zwilcox/RetroActiveDesign/Assembler/Error Message.jpg

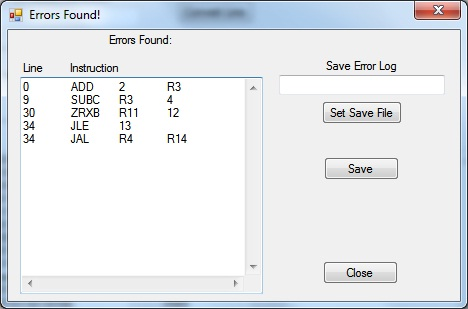
Assembler/Error Message.jpg
