zwilcox/RetroActiveDesign/Assembler/Assembler.jpg

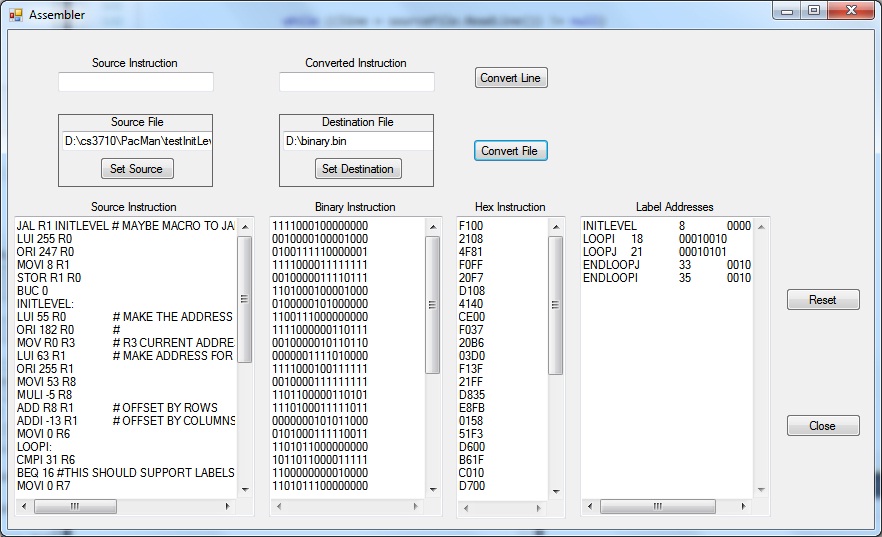
Assembler/Assembler.jpg
