zwilcox/RetroActiveDesign/Application/ImageToGlyph/README.txt

The glyph jpegs are available at the following URL:

http://eng.utah.edu/~ferro/JPEG2.zip
