zwilcox/RetroActiveDesign/System Schematic.bmp

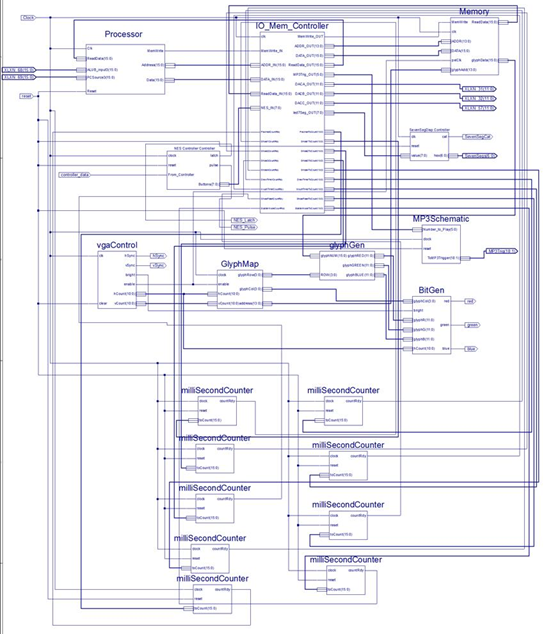
System Schematic.bmp
