zwilcox/RetroActiveDesign/Specification/Schematic User Guide.pdf

# Top Level Schematic:

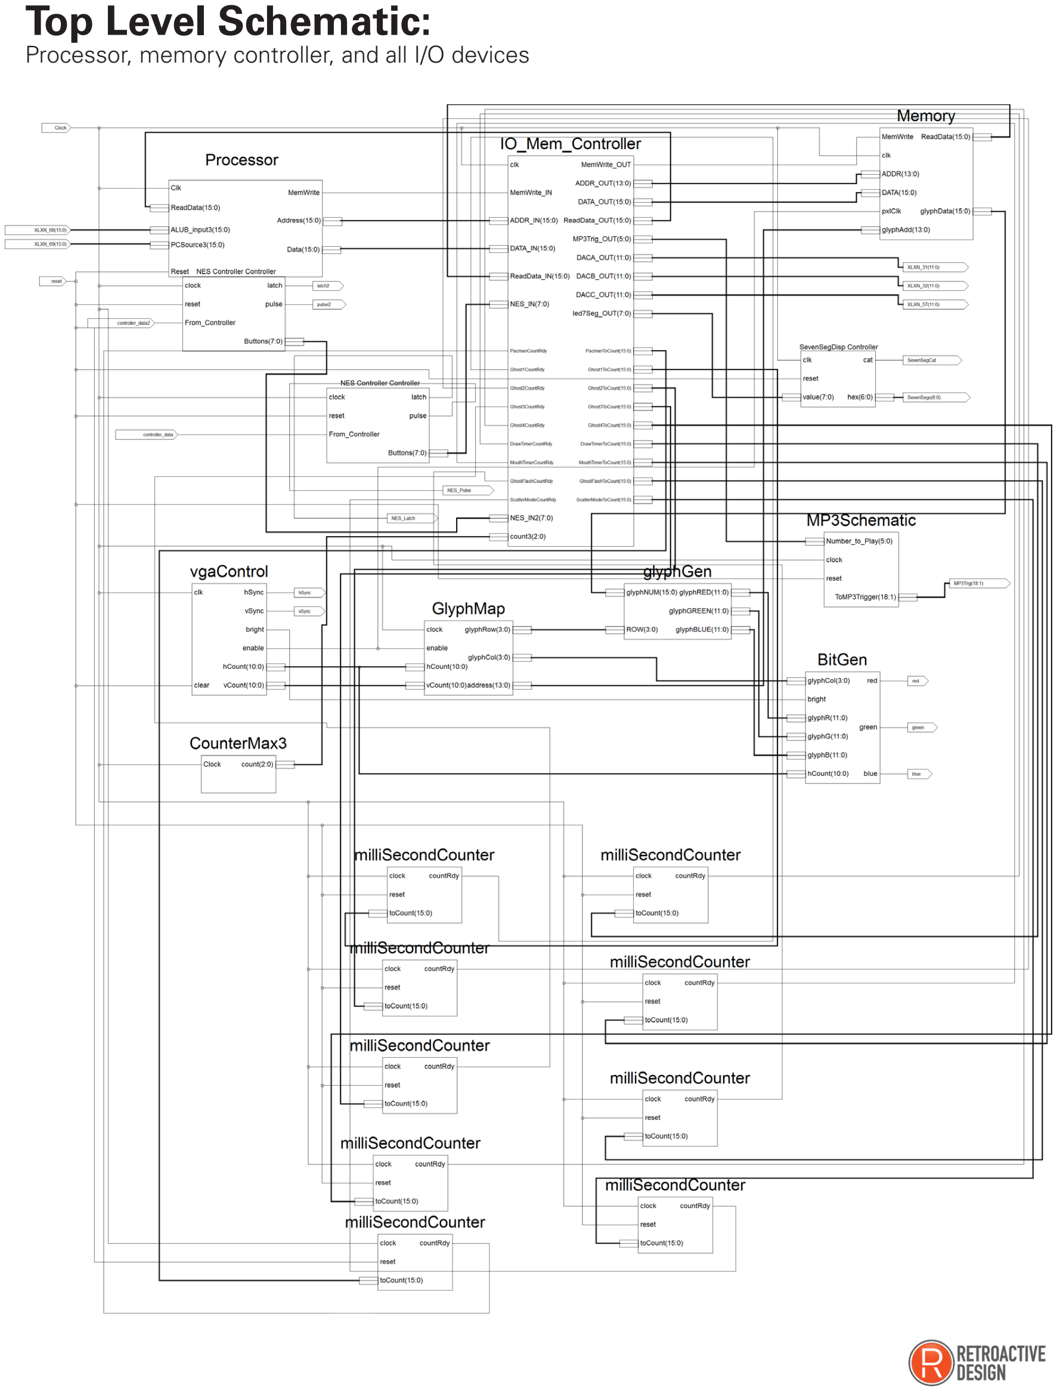
[picture p14: page 1]

Processor, memory controller, and all I/O devices

# Processor Schematic:

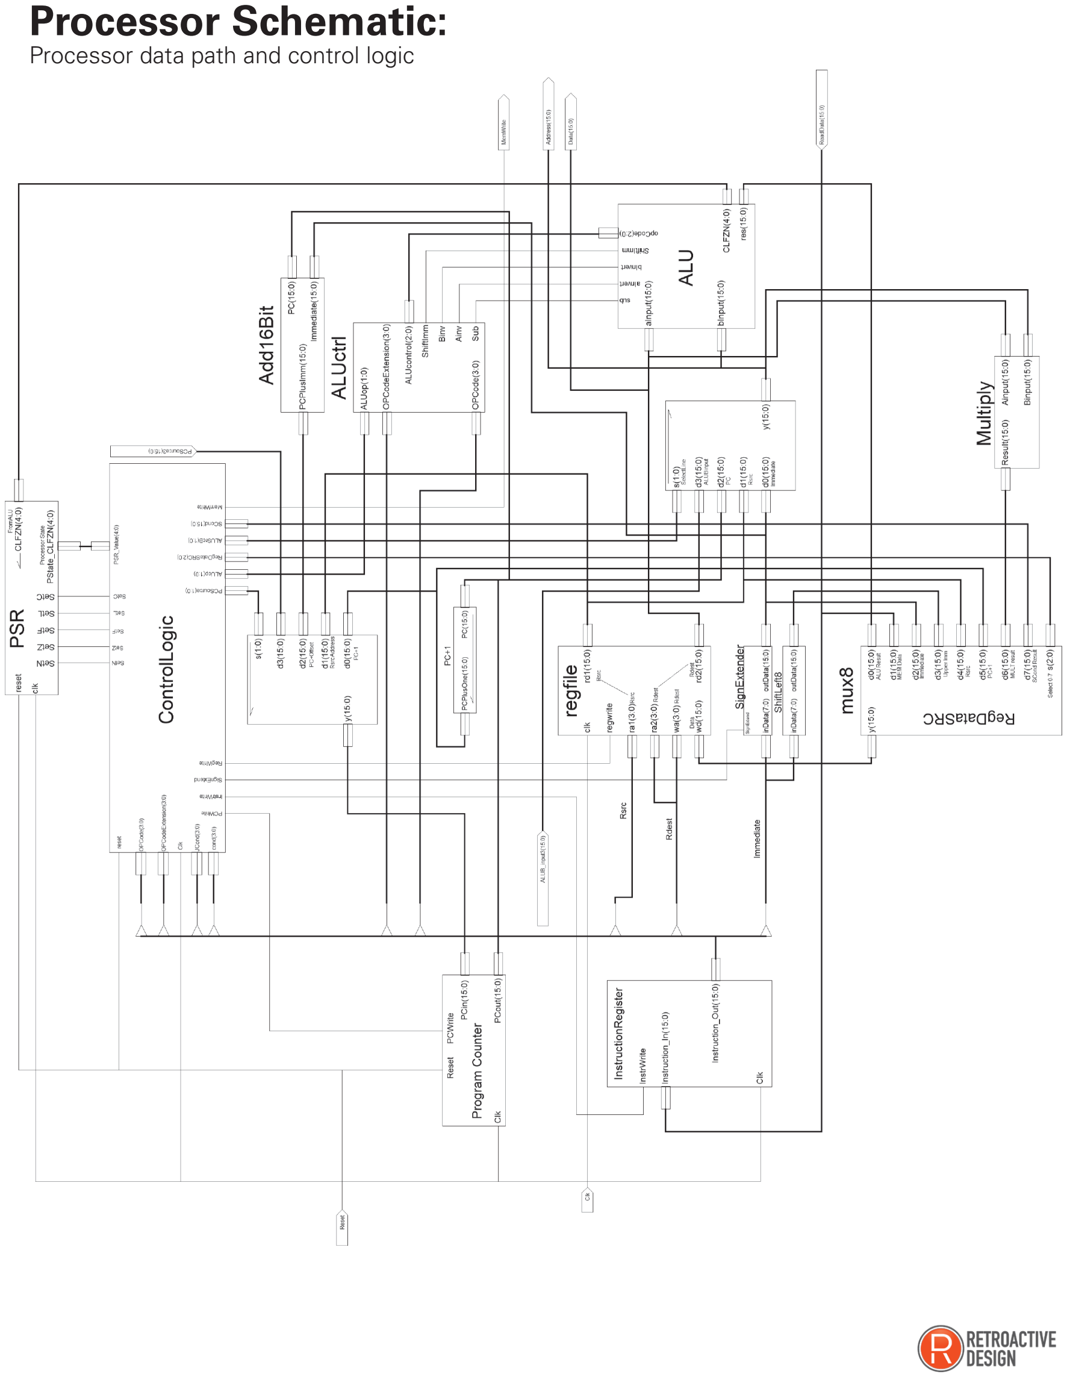
[picture p15: page 2]

Processor data path and control logic

# MP3 Controller Schematic:

MP3 Controller with clock divider.

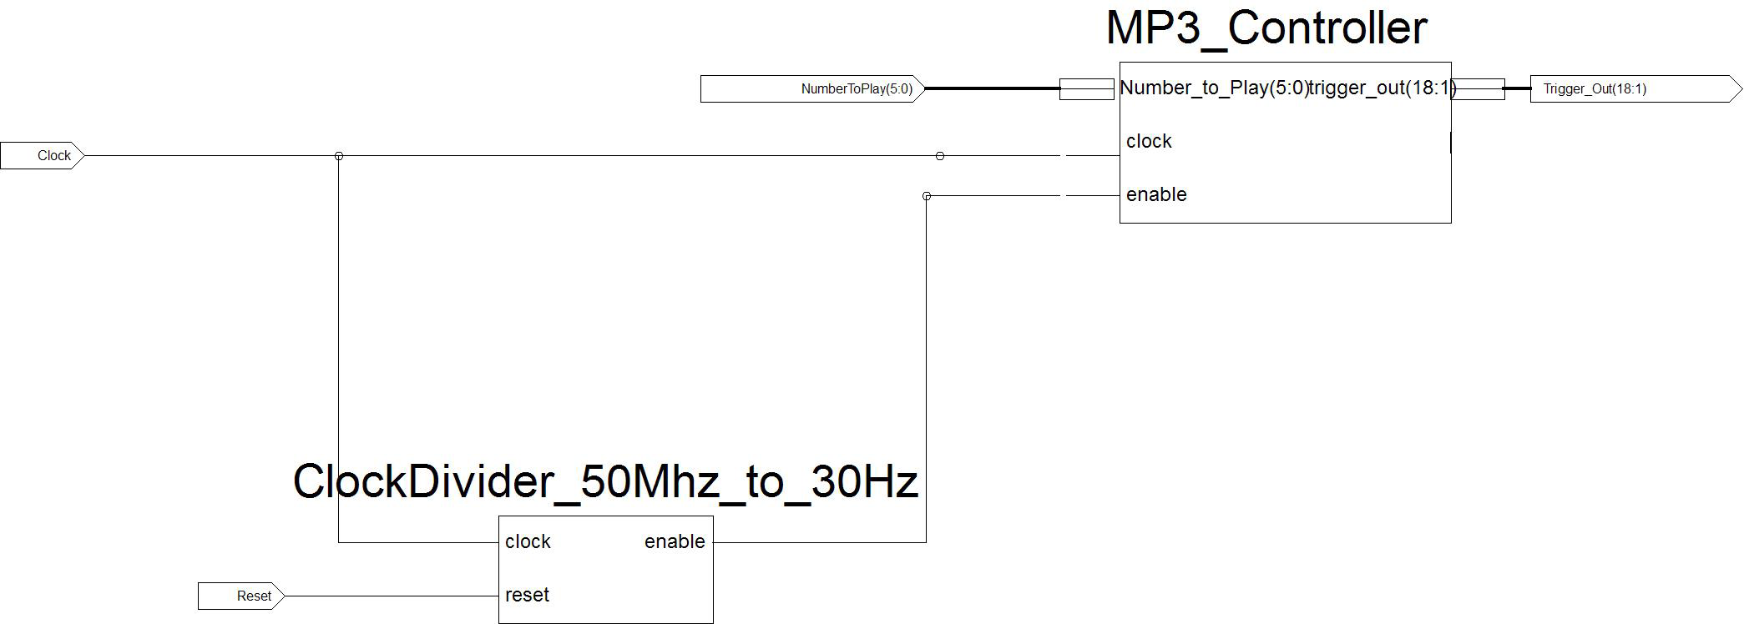
[picture p16: figure]

# NES Controller Schematic:

Clock divider and NESController state machine.

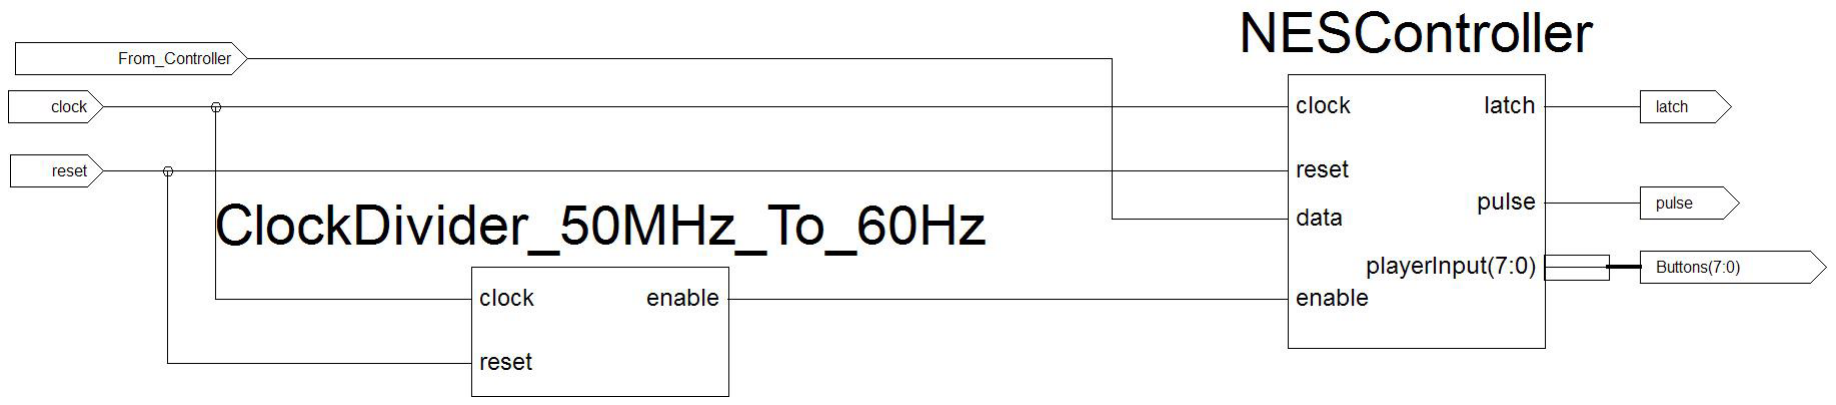
[picture p17: figure]
