zwilcox/RetroActiveDesign/Application/AssemblyCode/working_and_tmp_asm_files/testAssembly.txt

LUI 255 r1
MOVI 255 r6
OR r1 r6
MOVI 254 r7
OR r1 r7
MOVI 253 r8
OR r1 r8
MOVI 252 r9
OR r1 r9
MOVI 251 r10
OR r1 r10
MOVI 250 r11
OR r1 r11
MOVI 250 r12
OR r1 r12
MOVI 1 r5
LOAD r2 r6
CMPI 1 r2
BNE 3
STOR r5 r11
BUC -4
LOAD r2 r7
CMPI 1 r2
BNE 3
MOVI 18 r2
STOR r2 r11
LOAD r2 r8
CMPI 1 r2
BNE 3
MOVI 17 r2
STOR r2 r11
LOAD r2 r9
CMPI 1 r2
BNE 2
ADDI 1 r5
LOAD r2 r10
CMPI 1 r2
BNE 2
ADDI -1 r5
CMPI 13 r5
BGE 2
MOVI 1 r5
CMPI 0 r5
BLE 2
MOVI 12 r5
STOR r5 r12
MOVI 17 r2
JUC r2
