zwilcox/RetroActiveDesign/Application/AssemblyCode/working_and_tmp_asm_files/clearscreen_test2.txt

LUI 63 r2	
ORI 255 r2	// r2 is current fb index
LUI	58 r3
ORI 152 r3	// r3 is last square outside of fp
MOVI 1 r4   // load fb with glyph 0
compare:
CMP	r2 r3
BEQ two
STOR r4 r2
ADDI -1 r2
JUC r9 compare

two:
LUI 58 r2	
ORI 150 r2	// r2 is current fb index
LUI	55 r3
ORI 183 r3	// r3 is last square outside of fp
MOVI 114 r4   // load fb with glyph 0
compare2:
CMP	r3 r2
BEQ three
STOR r4 r2
ADDI -1 r2
JUC r9 compare2
