zwilcox/RetroActiveDesign/(commit log)

2013-09-01 Adding files to repo.
    [ALU_ALUCont_test_schematic.sch, Asteroid_System.sch, MP3Schematic.sch, NES_To_LED.sch, Processor.sch, Schem.sch, mp3_schem.sch, to_dac_test.sch]
2013-09-01 Added schematics.
